wenj-yan/-/cankao/2.进度对照与中期检查/研讨记录/研讨记录3.docx

综合工程设计课题组每周研讨记录

课程名称：综合工程设计 课程号：0727A015 指导教师： 张绍军

课题名称 | 简易音频分析仪设计
第 3 周 | | | 记录日期 | 12.7
姓名 | 杨毅、晋远帆 | 分工 | fpga编程 | | 考勤 | | 出勤
完成工作 | 调试正弦波发送程序。
存在问题 | 正弦波数据有错误。
下次任务 | 继续调试正弦波发送程序设计。
姓名 | 黄小泽 | 分工 | 电路设计 | | 考勤 | | 出勤
完成工作 | 学习PCB layout
存在问题 | 无
下次任务 | 5V转3.3V、5V电压芯片选型
姓名 | 晋远帆、王锐 | 分工 | 上位机程序设计 | | 考勤 | | 出勤
完成工作 | 用python代码编写接收UDP的代码
存在问题 | 无
下次任务 | 建立数据库，用于储存接收到的的数据
姓名 | 周俍琦 | 分工 | 外壳架构设计 | | | 考勤 | 出勤
完成工作 | 无
存在问题 | 无
下次任务 | 5V转3.3V、5V电压芯片选型

指导教师签名：
