wenj-yan/-/cankao/2.进度对照与中期检查/研讨记录/研讨记录6.docx

综合工程设计课题组每周研讨记录

课程名称：综合工程设计 课程号：0727A015 指导教师： 张绍军

课题名称 | 简易音频分析仪设计
第 6 周 | | | 记录日期 | 12.28
姓名 | 杨毅、晋远帆 | 分工 | fpga编程 | | 考勤 | | 出勤
完成工作 | 等待pcb板完成，帮助其他模块实施工作。
存在问题 | 无
下次任务 | 联合pcb板调试。
姓名 | 黄小泽 | 分工 | 电路设计 | | 考勤 | | 出勤
完成工作 | PCB layout
存在问题 | PCB layout部分细节缺失
下次任务 | PCB打板并焊接
姓名 | 晋远帆、王锐 | 分工 | 上位机程序设计 | | 考勤 | | 出勤
完成工作 | 设计用户界面，显示分析得到的数据
存在问题 | 无
下次任务 | 优化界面
姓名 | 周俍琦 | 分工 | 外壳架构设计 | | | 考勤 | 出勤
完成工作 | 协助PCB layout
存在问题 | 无
下次任务 | 协助焊接

指导教师签名：
