wenj-yan/-/cankao/code/3D外壳/3d外壳说明.docx

FPGA板建模：

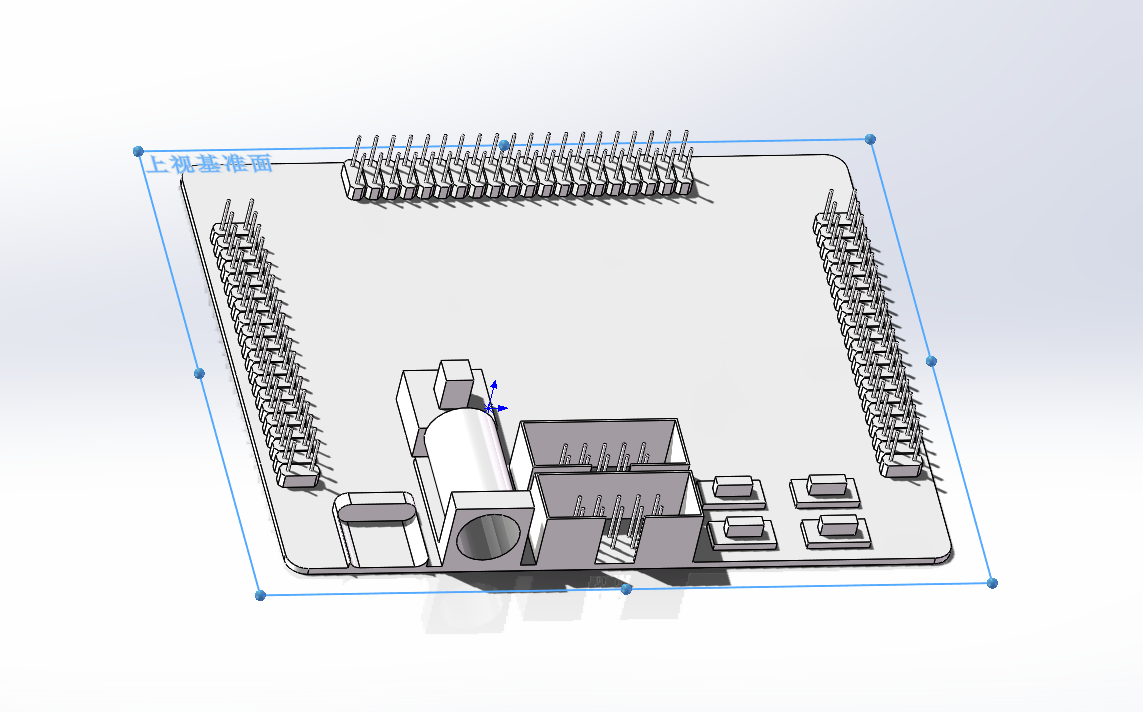
[picture p5: figure]

以太网模块建模：

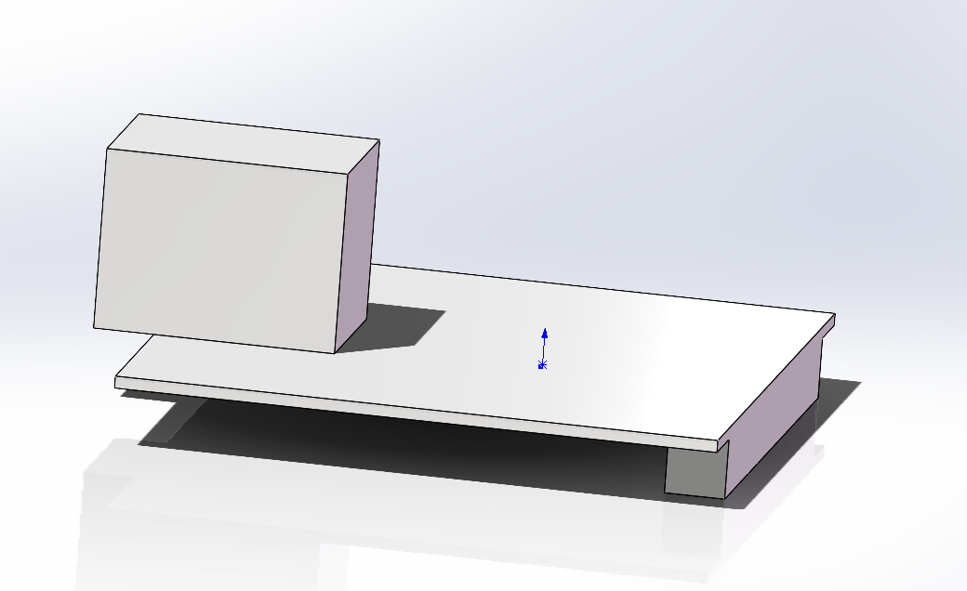
[picture p6: figure]

Pcb板建模：

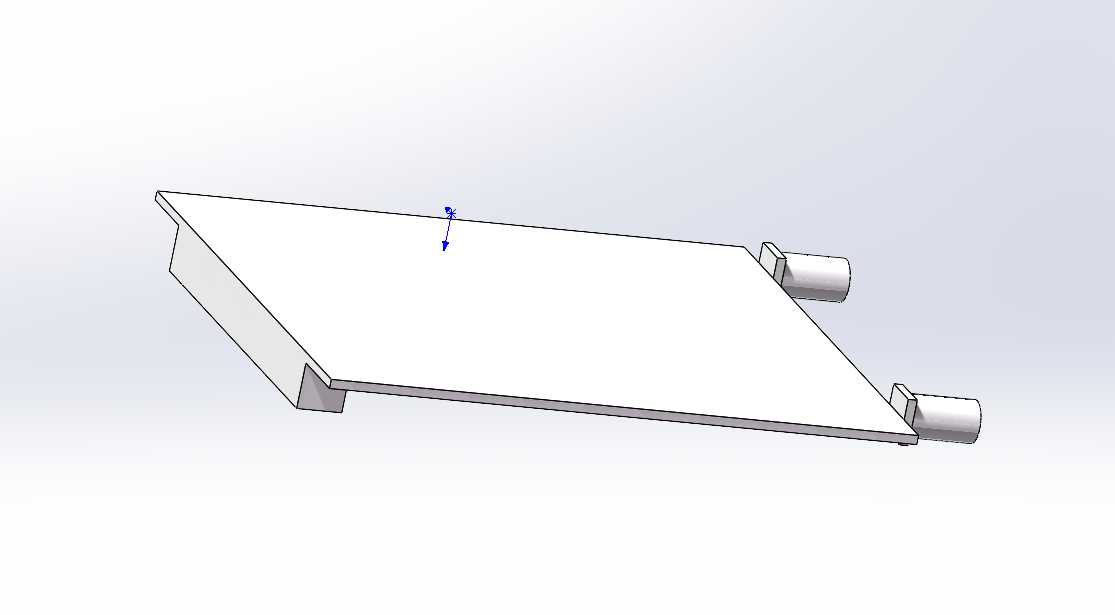
[picture p7: figure]

硬件装配体：

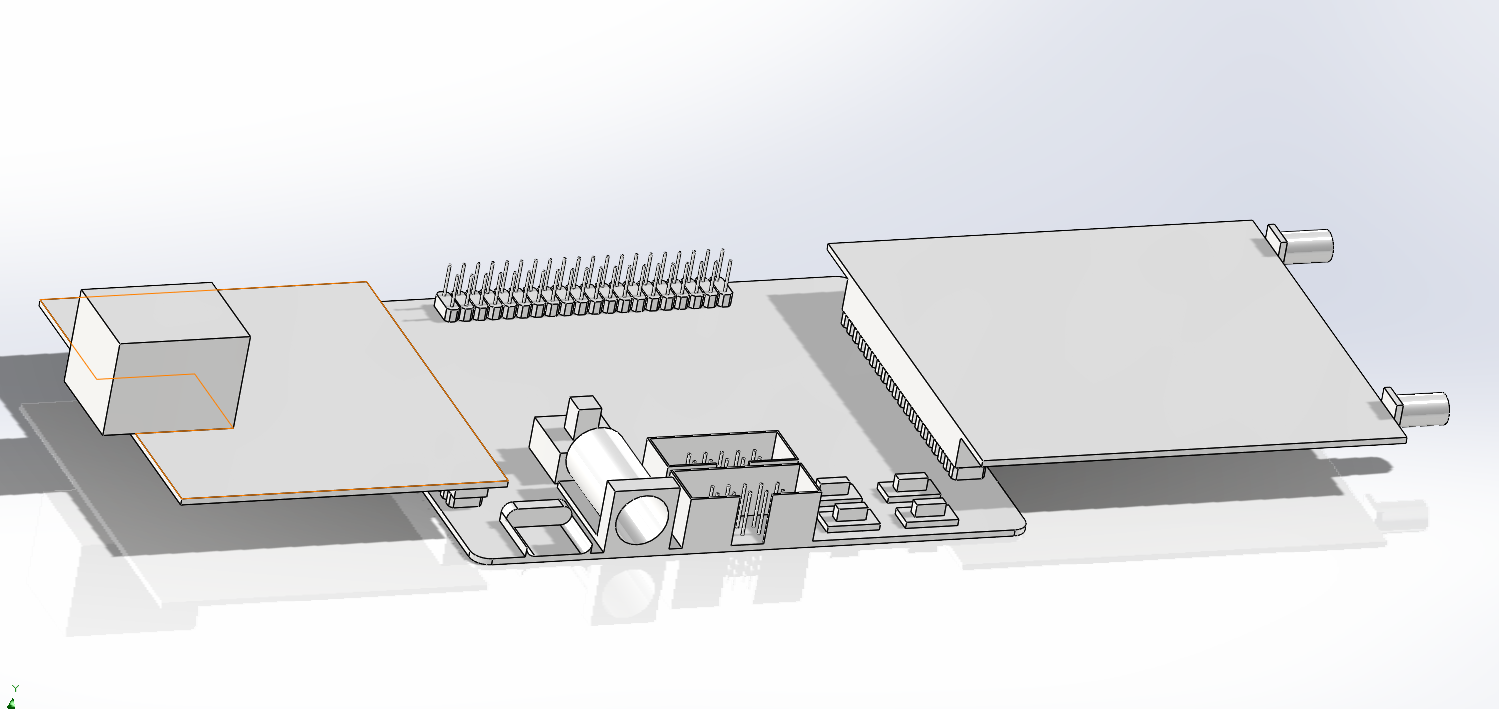
[picture p8: figure]

外壳底座建模：

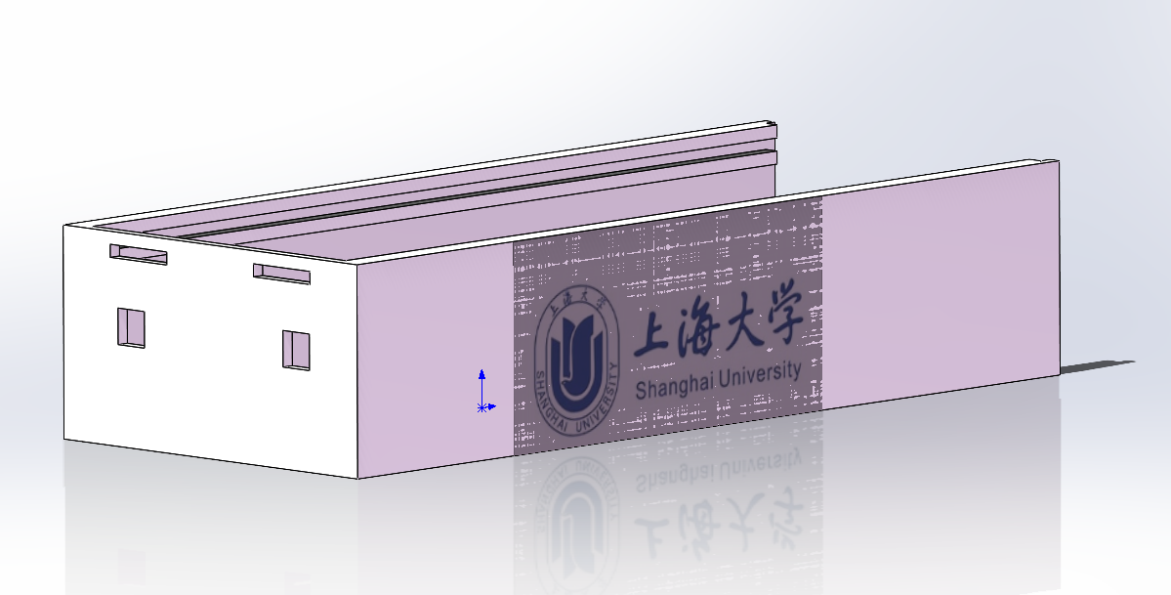
[picture p9: figure]

外壳底座三视图：

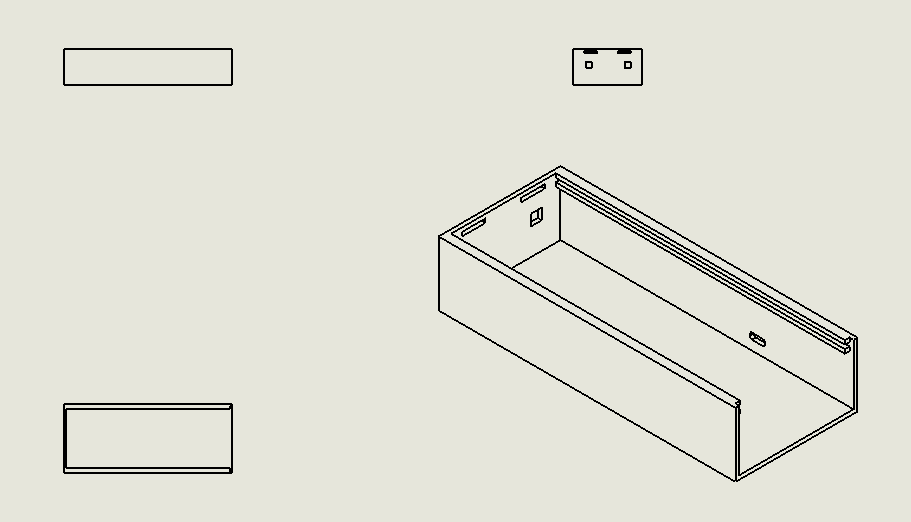
[picture p10: figure]

外壳盖建模：

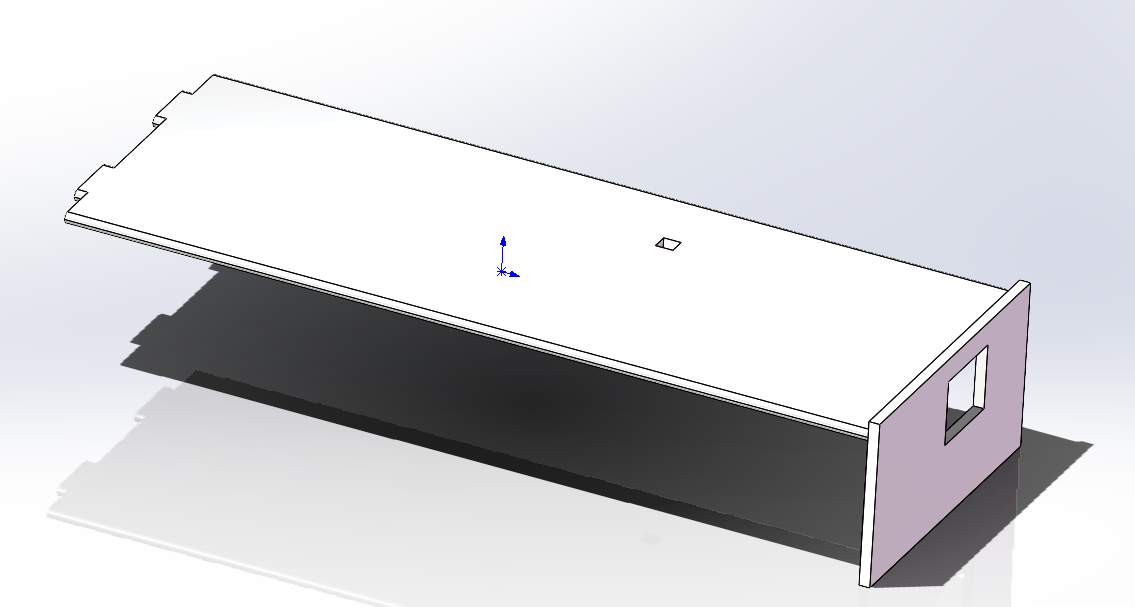
[picture p11: figure]

外壳盖三视图：

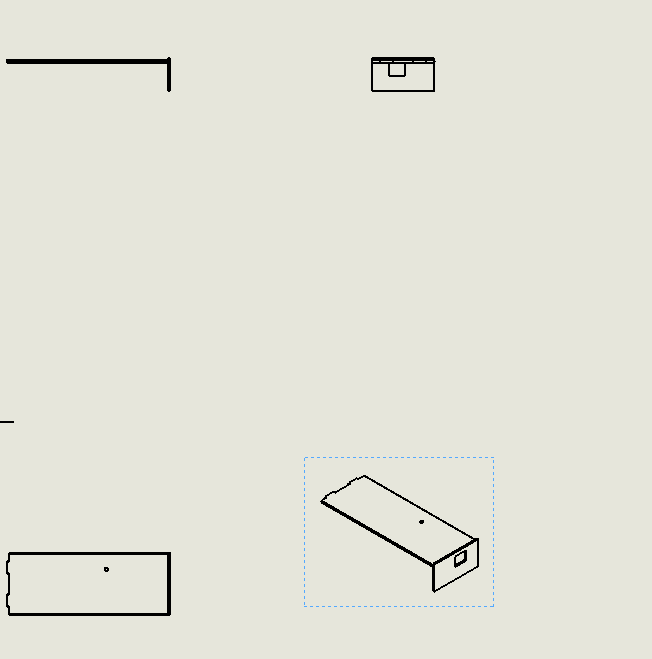
[picture p12: figure]

按钮建模：

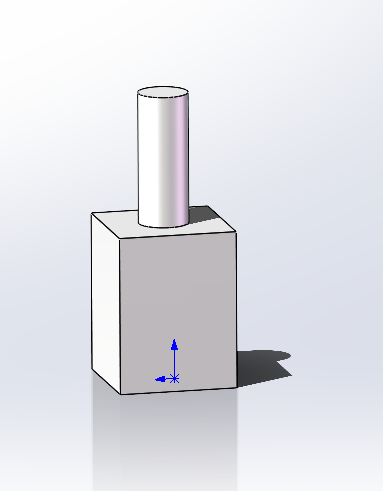
[picture p13: figure]

外壳装配体：

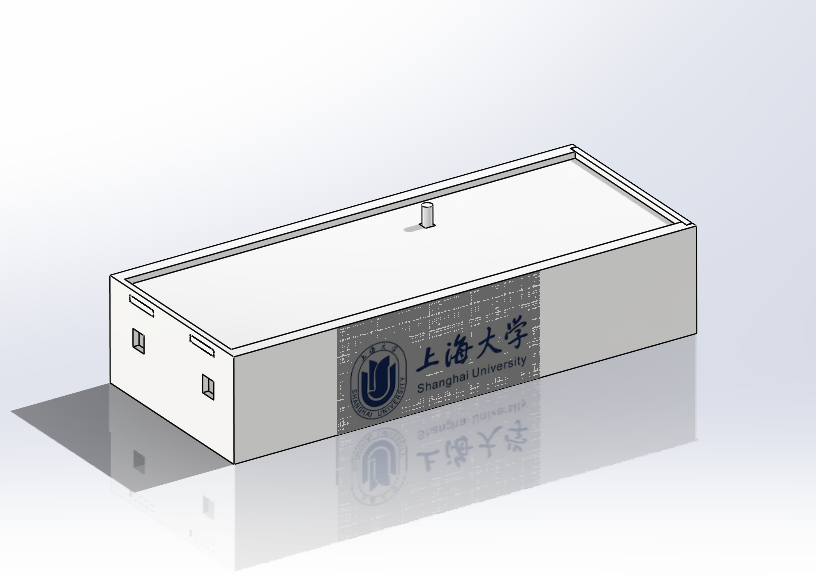
[picture p14: figure]
