wenj-yan/-/cankao/2.进度对照与中期检查/研讨记录/研讨记录1.docx

综合工程设计课题组每周研讨记录

课程名称：综合工程设计 课程号：0727A015 指导教师： 张绍军

课题名称 | 简易音频分析仪设计
第 1 周 | | | 记录日期 | 11.23
姓名 | 杨毅、晋远帆 | 分工 | fpga编程 | | 考勤 | | 出勤
完成工作 | 学习udp基础知识，并完成开题报告。
存在问题 | 无
下次任务 | 继续完成可行性报告，并学习fpga基础知识。
姓名 | 黄小泽 | 分工 | 电路设计 | | 考勤 | | 出勤
完成工作 | 调研并初步完成芯片选型
存在问题 | 无
下次任务 | 撰写开题报告。
姓名 | 晋远帆、王锐 | 分工 | 上位机程序设计 | | 考勤 | | 出勤
完成工作 | 学习udp有关python的基础知识，并完成开题报告。
存在问题 | 无
下次任务 | 撰写开题报告
姓名 | 周俍琦 | 分工 | 外壳架构设计 | | | 考勤 | 出勤
完成工作 | 调研并初步完成芯片选型
存在问题 | 无
下次任务 | 撰写开题报告。

指导教师签名：
