wenj-yan/-/cankao/2.进度对照与中期检查/研讨记录/研讨记录2.docx

综合工程设计课题组每周研讨记录

课程名称：综合工程设计 课程号：0727A015 指导教师： 张绍军

课题名称 | 简易音频分析仪设计
第 2 周 | | | 记录日期 | 11.30
姓名 | 杨毅、晋远帆 | 分工 | fpga编程 | | 考勤 | | 出勤
完成工作 | 继续学习udp知识，在开发板官网上找相应程序。
存在问题 | 测试程序有很多，结合网上程序进行调试。
下次任务 | 尝试发送正弦波数据。
姓名 | 黄小泽 | 分工 | 电路设计 | | 考勤 | | 出勤
完成工作 | 撰写开题报告
存在问题 | 无
下次任务 | 学习PCB layout
姓名 | 晋远帆、王锐 | 分工 | 上位机程序设计 | | 考勤 | | 出勤
完成工作 | 撰写开题报告
存在问题 | 无
下次任务 | 用python代码编写接收UDP的代码
姓名 | 周俍琦 | 分工 | 外壳架构设计 | | | 考勤 | 出勤
完成工作 | 撰写开题报告
存在问题 | 无
下次任务 | 无

指导教师签名：
