wenj-yan/-/cankao/2.进度对照与中期检查/研讨记录/研讨记录5.docx

综合工程设计课题组每周研讨记录

课程名称：综合工程设计 课程号：0727A015 指导教师： 张绍军

课题名称 | 简易音频分析仪设计
第 5 周 | | | 记录日期 | 12.21
姓名 | 杨毅、晋远帆 | 分工 | fpga编程 | | 考勤 | | 出勤
完成工作 | 继续调试
存在问题 | 无
下次任务 | 等待pcb板，准备分通道程序。
姓名 | 黄小泽 | 分工 | 电路设计 | | 考勤 | | 出勤
完成工作 | 原理图绘制
存在问题 | 无
下次任务 | PCB layout
姓名 | 晋远帆、王锐 | 分工 | 上位机程序设计 | | 考勤 | | 出勤
完成工作 | 利用python测量信号电平、频率、总谐波失真、信噪比等参数
存在问题 | 信噪比计算出现错误
下次任务 | 设计用户界面，显示分析得到的数据
姓名 | 周俍琦 | 分工 | 外壳架构设计 | | | 考勤 | 出勤
完成工作 | 协助原理图绘制
存在问题 | 无
下次任务 | 协助PCB layout

指导教师签名：
