wenj-yan/-/cankao/2.进度对照与中期检查/研讨记录/研讨记录7.docx

综合工程设计课题组每周研讨记录

课程名称：综合工程设计 课程号：0727A015 指导教师： 张绍军

课题名称 | 简易音频分析仪设计
第 7 周 | | | 记录日期 | 1.4
姓名 | 杨毅、晋远帆 | 分工 | fpga编程 | | 考勤 | | 出勤
完成工作 | 写ad模块驱动程序
存在问题 | 发包数据存在问题
下次任务 | 继续修改程序并调试。
姓名 | 黄小泽 | 分工 | 电路设计 | | 考勤 | | 出勤
完成工作 | PCB打板并焊接
存在问题 | 电路存在运放不工作
下次任务 | 电路调试
姓名 | 晋远帆、王锐 | 分工 | 上位机程序设计 | | 考勤 | | 出勤
完成工作 | 优化界面，补充界面其他功能
存在问题 | 无
下次任务 | 调式代码，并进行相应的优化
姓名 | 周俍琦 | 分工 | 外壳架构设计 | | | 考勤 | 出勤
完成工作 | 协助焊接
存在问题 | 无
下次任务 | 协助电路调试

指导教师签名：
