wenj-yan/-/cankao/2.进度对照与中期检查/研讨记录/研讨记录9.docx

综合工程设计课题组每周研讨记录

课程名称：综合工程设计 课程号：0727A015 指导教师： 张绍军

课题名称 | 简易音频分析仪设计
第 9 周 | | | 记录日期 | 1.18
姓名 | 杨毅、晋远帆 | 分工 | fpga编程 | | 考勤 | | 出勤
完成工作 | 完成分通道程序
存在问题 | 无
下次任务 | 无
姓名 | 黄小泽 | 分工 | 电路设计 | | 考勤 | | 出勤
完成工作 | 电路调试完成
存在问题 | 无
下次任务 | 联合调试。
姓名 | 晋远帆、王锐 | 分工 | 上位机程序设计 | | 考勤 | | 出勤
完成工作 | 增加界面功能，让用户体验更好
存在问题 | 无
下次任务 | 联合调试。
姓名 | 周俍琦 | 分工 | 外壳架构设计 | | | 考勤 | 出勤
完成工作 | 3D打印外壳。
存在问题 | 无
下次任务 | 无

指导教师签名：
