wenj-yan/-/cankao/code/Python_App/shu.jpeg

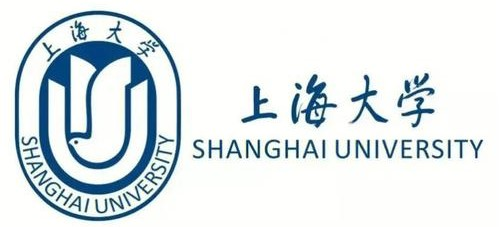
cankao/code/Python_App/shu.jpeg
