wenj-yan/-/PCB/BOM_Board1_Schematic1_2024-04-16.xlsx

No. | Quantity | Comment | Designator | Footprint | Value | Manufacturer Part | Manufacturer | Supplier Part | Supplier
1 | 15 | 100nF | C1,C2,C3,C4,C5,C8,C9,C12,C13,C15,C16,C17,C19,C21,C22 | C0805 | 100nF | 0805B104K500NT | FH(风华) | C38141 | LCSC
2 | 2 | 22uF | C18,C20 | C0805 | 22uF | CL21A226MAQNNNE | SAMSUNG(三星) | C45783 | LCSC
3 | 5 | 10uF | C23,C24,C25,C26,C27 | C0805 | 10uF | GRM21BR61H106KE43L | muRata(村田) | C440198 | LCSC
4 | 1 | 1uH | L1 | L0805 | 1uH | SDFL2012Q1R0KTF | Sunlord(顺络) | C1042 | LCSC
5 | 1 | 2kΩ | R1 | R0805 | 2kΩ | 0805W8F2001T5E | UNI-ROYAL(厚声) | C17604 | LCSC
6 | 2 | 50Ω | R2,R3 | R0805 | 50Ω | ARG05FTC0500 | Viking(光颉) | C2828866 | LCSC
7 | 2 | 18Ω | R4,R5 | R0805 | 18Ω | FRC0805J180TS | FOJAN(富捷) | C2930252 | LCSC
8 | 1 | 820Ω | R6 | R0805 | 820Ω | 0805W8F8200T5E | UNI-ROYAL(厚声) | C17837 | LCSC
9 | 24 | 22Ω | R7,R8,R9,R10,R11,R12,R13,R14,R15,R16,R17,R18,R19,R20,R21,R22,R23,R24,R25,R26,R27,R28,R29,R30 | R0805 | 22Ω | 0805W8F220JT5E | UNI-ROYAL(厚声) | C17561 | LCSC
10 | 2 | HJ-SMA023 | RF3,RF4 | SMA-SMD_HJ-SMA023 |  | HJ-SMA023 | 皇捷 | C1509219 | LCSC
11 | 1 | ADS807E | U1 | SSOP-28_L10.2-W5.3-P0.65-LS7.8-BL |  | ADS807E | TI(德州仪器) | C1542930 | LCSC
12 | 1 | DAC902U | U2 | SOIC-28_L18.0-W7.5-P1.27-LS10.3-BL |  | DAC902U | TI(德州仪器) | C1555011 | LCSC
13 | 1 | LM1117IMPX-3.3/NOPB | U6 | SOT-223_L6.5-W3.5-P2.30-LS7.0-BR |  | LM1117IMPX-3.3/NOPB | TI(德州仪器) | C23984 | LCSC
14 | 1 | ZX-PM2.54-2-20PY | U9 | HDR-TH_40P-P2.54-V-F-R2-C20-S2.54 |  | ZX-PM2.54-2-20PY | Megastar(兆星) | C7499354 | LCSC
15 | 3 | EXCML16A270U | U10,U11,U12 | L0603
16 | 2 | ADT1-1WT+ | U13,U14 | XFMR-SMD_6P-L7.9-W5.6-P2.54-LS7.0-BL |  | ADT1-1WT+ | Mini-Circuits | C6835853 | LCSC
