wenj-yan/-/cankao/code/3D外壳/装配体2.SLDASM

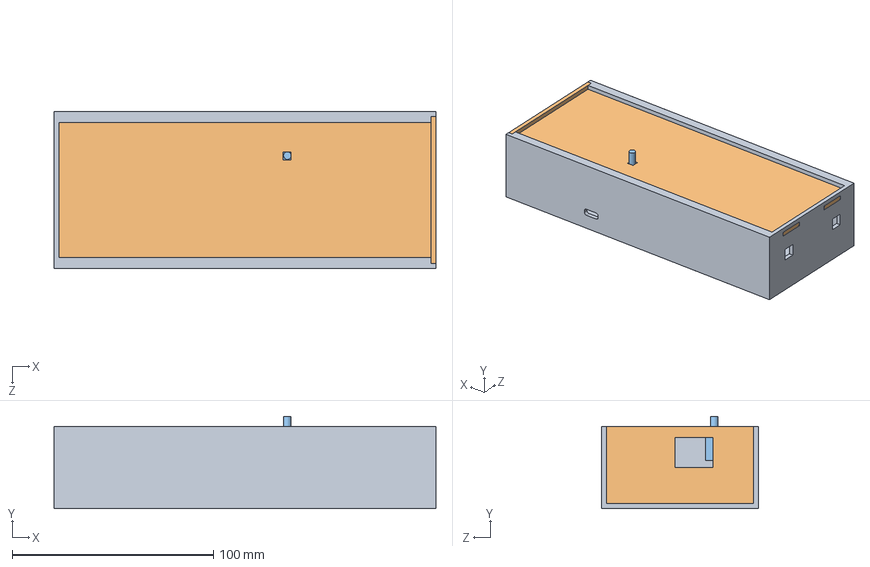
[picture p49: CAD file, 2024-10-17]
cankao/code/3D外壳/装配体2.SLDASM
190.0 x 46.0 x 78.0 mm
外壳
外壳2
按钮
