wenj-yan/-/cankao/code/3D外壳/装配体1.SLDASM

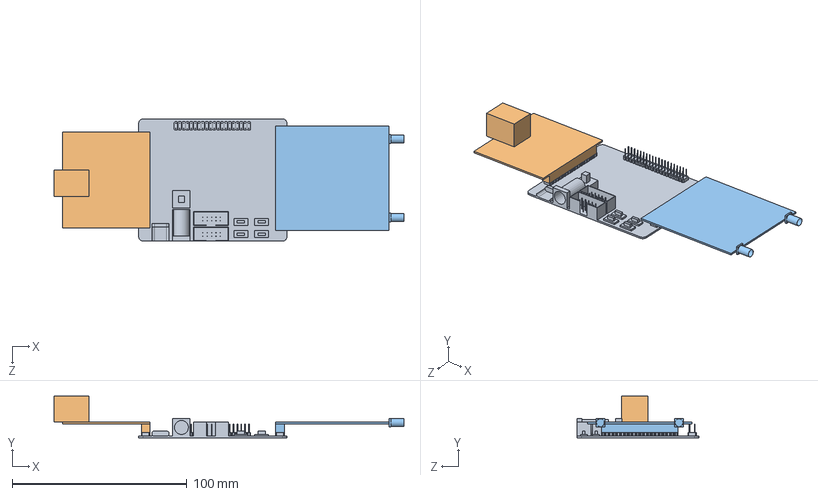
[picture p50: CAD file, 2024-10-17]
cankao/code/3D外壳/装配体1.SLDASM
200.5 x 24.0 x 70.0 mm
FPGA板
以太网模块
pcb板
