wenj-yan/-/3D/外壳2.STL

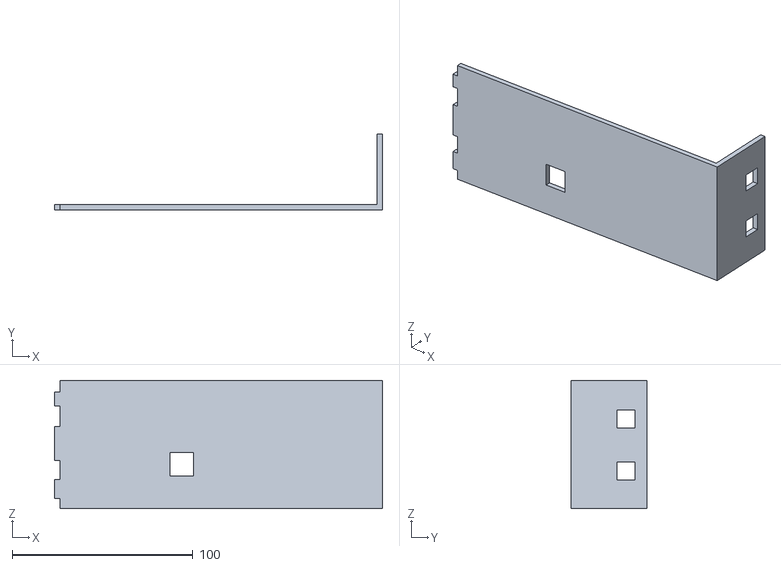
[picture p51: CAD file, 2024-10-17]
3D/外壳2.STL
181.5 x 42.0 x 71.0
