wenj-yan/-/cankao/code/3D外壳/按钮.STEP

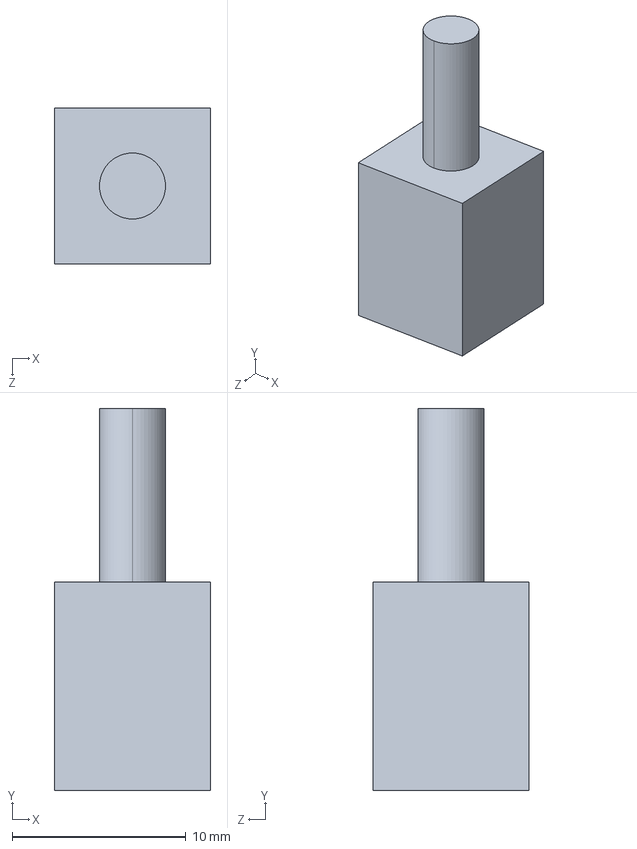
[picture p52: CAD file, 2024-10-17]
cankao/code/3D外壳/按钮.STEP
9.00 x 22.0 x 9.00 mm
