wenj-yan/-/3D/外壳1.STL

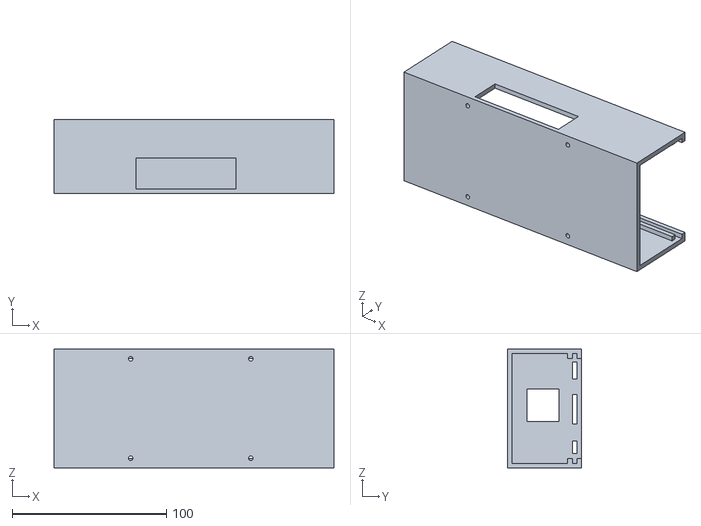
[picture p53: CAD file, 2024-10-17]
3D/外壳1.STL
181.5 x 48.0 x 77.0
