wenj-yan/-/cankao/code/3D外壳/外壳.STEP

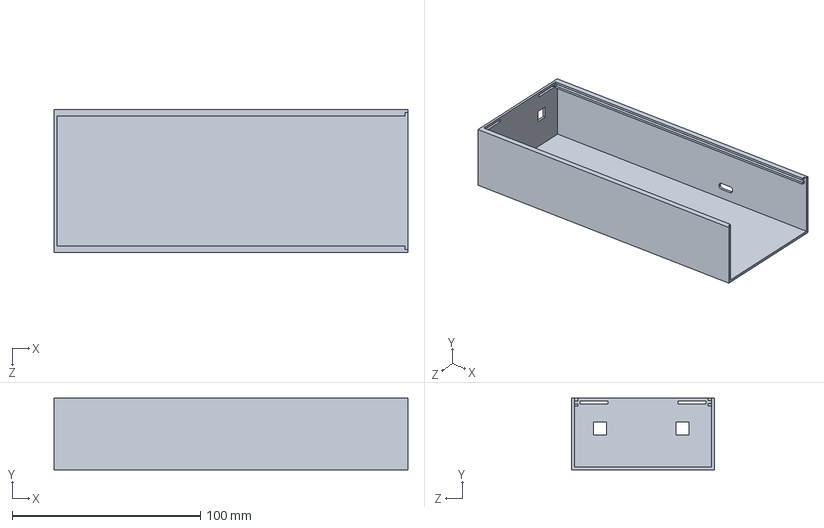
[picture p54: CAD file, 2024-10-17]
cankao/code/3D外壳/外壳.STEP
188.0 x 38.0 x 76.0 mm
