wenj-yan/-/cankao/code/3D外壳/FPGA板.SLDPRT

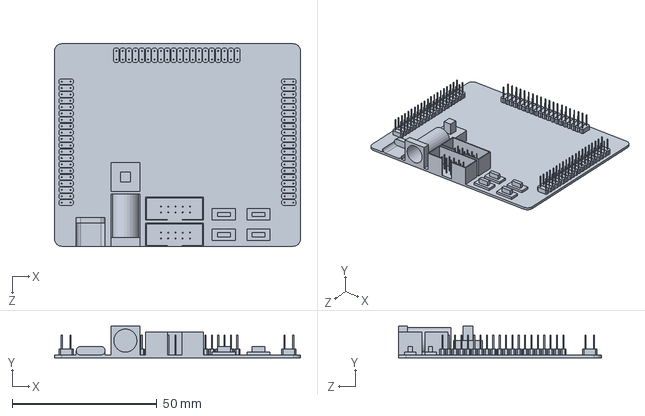
[picture p55: CAD file, 2024-10-17]
cankao/code/3D外壳/FPGA板.SLDPRT
85.0 x 11.0 x 70.0 mm
