wenj-yan/-/cankao/code/3D外壳/pcb板.SLDPRT

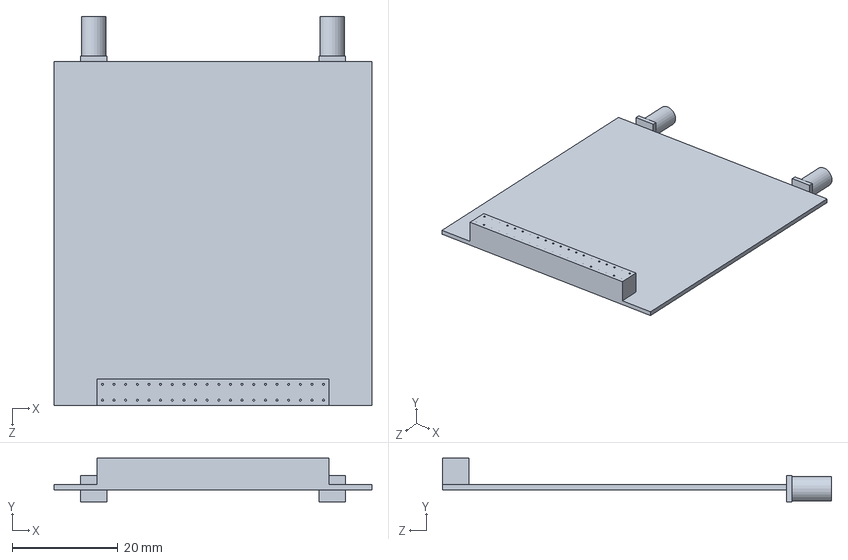
[picture p56: CAD file, 2024-10-17]
cankao/code/3D外壳/pcb板.SLDPRT
60.0 x 8.25 x 73.5 mm
