wenj-yan/-/cankao/code/3D外壳/外壳2.STEP

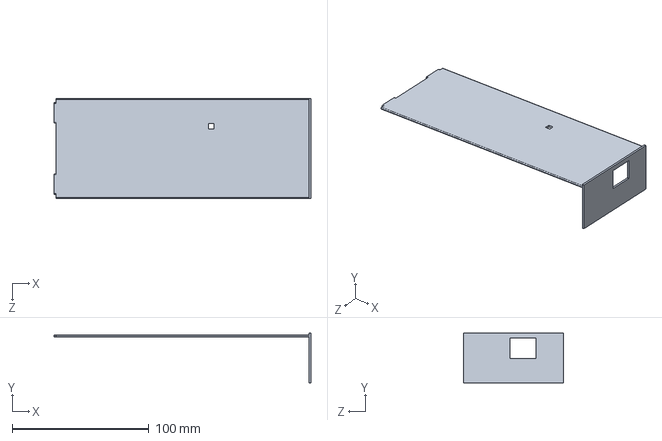
[picture p57: CAD file, 2024-10-17]
cankao/code/3D外壳/外壳2.STEP
188.0 x 36.5 x 73.0 mm
