wenj-yan/-/cankao/code/3D外壳/以太网模块.SLDPRT

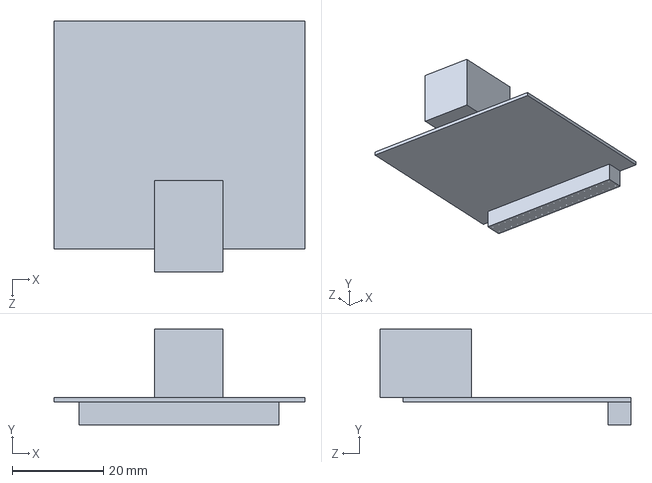
[picture p58: CAD file, 2024-10-17]
cankao/code/3D外壳/以太网模块.SLDPRT
55.0 x 21.0 x 55.0 mm
