wenj-yan/-/(list of files, cad)

Other CAD files:
cankao/code/FPGA/v7_completed/db/stp1_auto_stripped.stp
cankao/code/FPGA/v7_completed/stp1.stp
code/huihuan/EP4CE10_V1.1_Ethernet_1G/Project/db/stp1_auto_stripped.stp
code/huihuan/EP4CE10_V1.1_Ethernet_1G/Project/stp1.stp
code/huihuan_2/huihuan/EP4CE10_V1.1_Ethernet_1G/Project/db/stp1_auto_stripped.stp
code/huihuan_2/huihuan/EP4CE10_V1.1_Ethernet_1G/Project/stp1.stp
cankao/code/FPGA/v7_completed/stp1_auto_stripped.stp
code/huihuan_2/huihuan/EP4CE10_V1.1_Ethernet_1G/Project/stp1_auto_stripped.stp
cankao/code/3D外壳/外壳.SLDPRT
cankao/code/3D外壳/外壳.STL
cankao/code/3D外壳/外壳2.SLDPRT
cankao/code/3D外壳/外壳2.STL
cankao/code/3D外壳/按钮.SLDPRT
cankao/code/3D外壳/按钮.STL
