wenj-yan/-/芯片手册/C492419_0001C06E73AFF21BD0ED3D7CEEF46D29.pdf

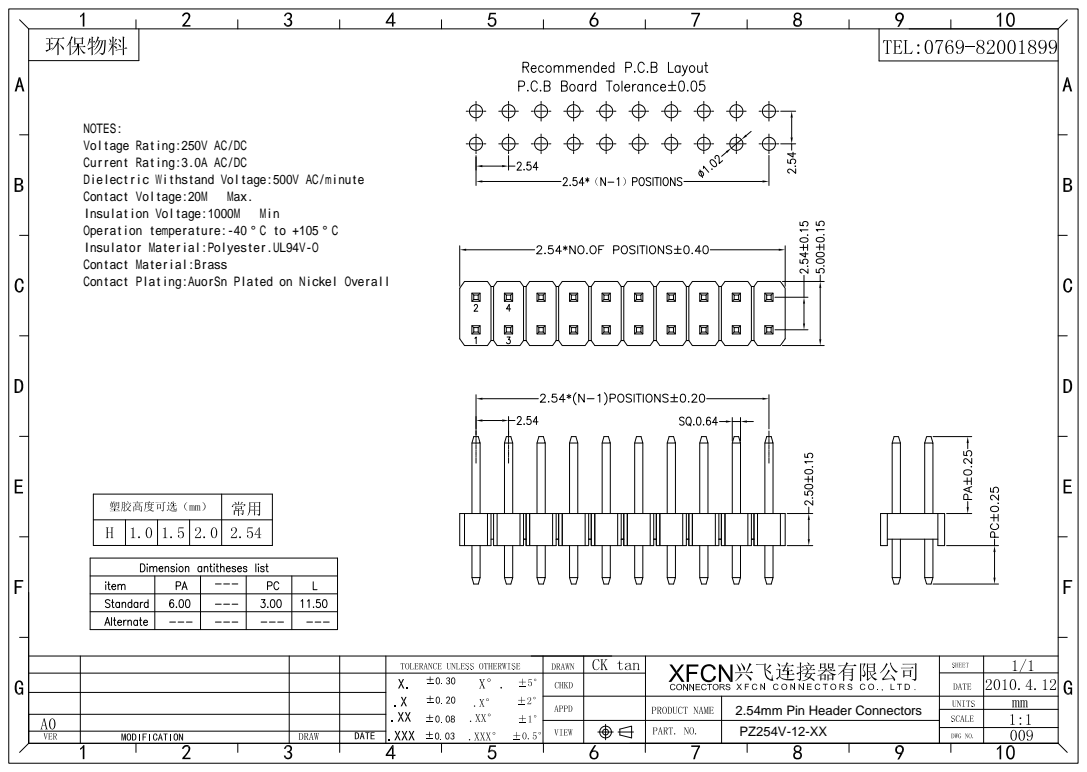
[picture p59: page 1]

2.54mm Pin Header Connectors
