wenj-yan/-/(list of files, drawings)

Other design files:
cankao/code/PCB/ADC.eprj
cankao/code/PCB/备份/ADC.eprj
