wenj-yan/-/cankao/code/FPGA/v7_completed/Src/sin_table.v

module sin_table(
	input [9:0]address,
	output reg[23:0]data
   );
always @(*)
begin
    case(address)
        10'd0: data <= 24'd8388607;
        10'd1: data <= 24'd8443510;
        10'd2: data <= 24'd8498410;
        10'd3: data <= 24'd8553306;
        10'd4: data <= 24'd8608195;
        10'd5: data <= 24'd8663075;
        10'd6: data <= 24'd8717942;
        10'd7: data <= 24'd8772796;
        10'd8: data <= 24'd8827633;
        10'd9: data <= 24'd8882451;
        10'd10: data <= 24'd8937248;
        10'd11: data <= 24'd8992022;
        10'd12: data <= 24'd9046770;
        10'd13: data <= 24'd9101489;
        10'd14: data <= 24'd9156178;
        10'd15: data <= 24'd9210834;
        10'd16: data <= 24'd9265455;
        10'd17: data <= 24'd9320039;
        10'd18: data <= 24'd9374582;
        10'd19: data <= 24'd9429083;
        10'd20: data <= 24'd9483540;
        10'd21: data <= 24'd9537950;
        10'd22: data <= 24'd9592310;
        10'd23: data <= 24'd9646619;
        10'd24: data <= 24'd9700874;
        10'd25: data <= 24'd9755073;
        10'd26: data <= 24'd9809213;
        10'd27: data <= 24'd9863293;
        10'd28: data <= 24'd9917309;
        10'd29: data <= 24'd9971260;
        10'd30: data <= 24'd10025143;
        10'd31: data <= 24'd10078956;
        10'd32: data <= 24'd10132696;
        10'd33: data <= 24'd10186362;
        10'd34: data <= 24'd10239951;
        10'd35: data <= 24'd10293461;
        10'd36: data <= 24'd10346888;
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
        10'd953: data <= 24'd8004418;
        10'd954: data <= 24'd8059272;
        10'd955: data <= 24'd8114139;
        10'd956: data <= 24'd8169019;
        10'd957: data <= 24'd8223908;
        10'd958: data <= 24'd8278804;
        10'd959: data <= 24'd8333704;
    endcase
end
endmodule
